estella34/bitirme_fc/docs/donanim/DONANIM_ENVANTERI.md

# Donanım envanteri (Aşama A)

Eldeki her parçanın model kodunu, elektrik değerlerini ve durumunu burada tutuyoruz. Etiket ve bağlantı fotoğraflarını `docs/donanim/foto/` altına koyun ve tabloda dosya adıyla anın. Bilinmeyen alanı tahminle doldurmayın, `?` bırakın.

**Durum değerleri:** `elde` · `sipariş` · `planlanan` · `arızalı`

## Hesaplama ve depolama

| Parça | Model / parça kodu | Elektrik değerleri | Durum | Fotoğraf | Not |
|---|---|---|---|---|---|
| Jetson Orin Nano Developer Kit | ? | 19 V DC | elde | | Bellek (8 GB?) `free -h` ile doğrulanacak |
| Jetson güç adaptörü | ? | ? V / ? A | ? | | |
| microSD kart | ? | — | ? | | Kapasite, hız sınıfı |
| NVMe SSD | ? | — | ? | | Kapasite, M.2 2280 PCIe mi? |

## Kameralar ve aydınlatma

| Parça | Model / parça kodu | Arayüz | Durum | Fotoğraf | Not |
|---|---|---|---|---|---|
| Kamera 1 | ? | CSI / USB? | planlanan | | Sensör, lens, odak türü |
| Kamera 2 | ? | | planlanan | | |
| Kamera 3 | ? | | planlanan | | |
| Kamera 4 | ? | | planlanan | | |
| Çoklu kamera kartı | ? | | ? | | Gerekirse |
| Aydınlatma (LED) | ? | ? V | planlanan | | |

## Araç (yatay hareket)

| Parça | Model / parça kodu | Elektrik değerleri | Durum | Fotoğraf | Not |
|---|---|---|---|---|---|
| Arduino | ? | | elde | | Uno / Mega / Nano? |
| Motor sürücü kartı | ? | ? V / ? A | elde | | |
| Araç motorları | ? | ? V | elde | | Adet, redüktör, enkoder var mı? |
| Batarya | ? | ? V / ? Ah | ? | | |

## Dikey eksen (sıfırdan yapılacak)

| Parça | Model / parça kodu | Elektrik değerleri | Durum | Fotoğraf | Not |
|---|---|---|---|---|---|
| Dikey eksen motoru | — | | planlanan | | Yük ve strok ölçülünce seçilecek |
| Motor sürücüsü | — | | planlanan | | |
| Kılavuz profil / ray | — | — | planlanan | | |
| Vida + somun + yataklar | — | — | planlanan | | |
| Limit anahtarları (2) | — | | planlanan | | |
| Kablo zinciri | — | — | planlanan | | |
