estella34/bitirme_fc/docs/referans/dexory-referans-2026-08-31.jpg

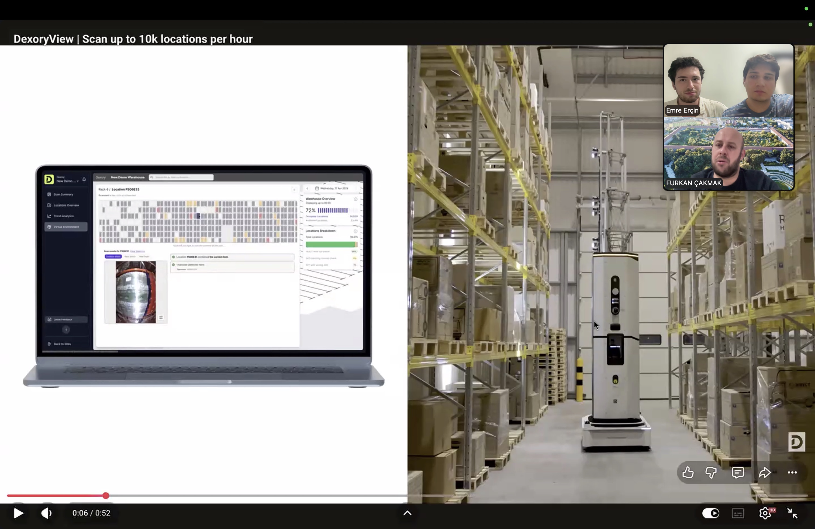
docs/referans/dexory-referans-2026-08-31.jpg
