estella34/bitirme_fc/mekanik/direk_3m/onizleme/base.png

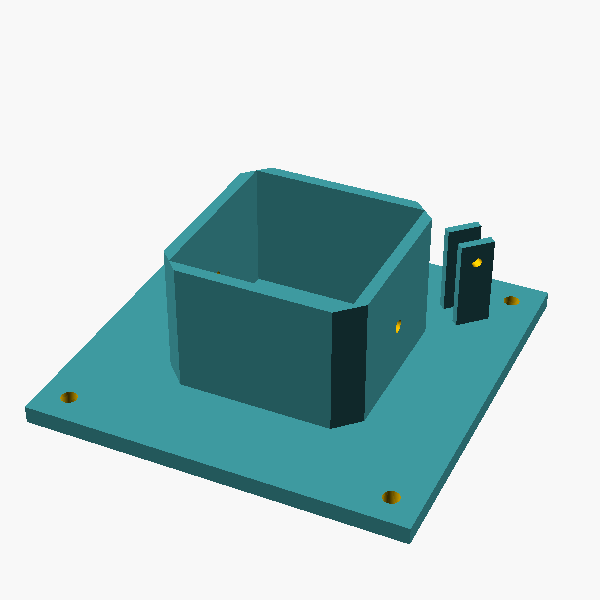
mekanik/direk_3m/onizleme/base.png
