estella34/bitirme_fc/mekanik/direk_3m/onizleme/cap3.png

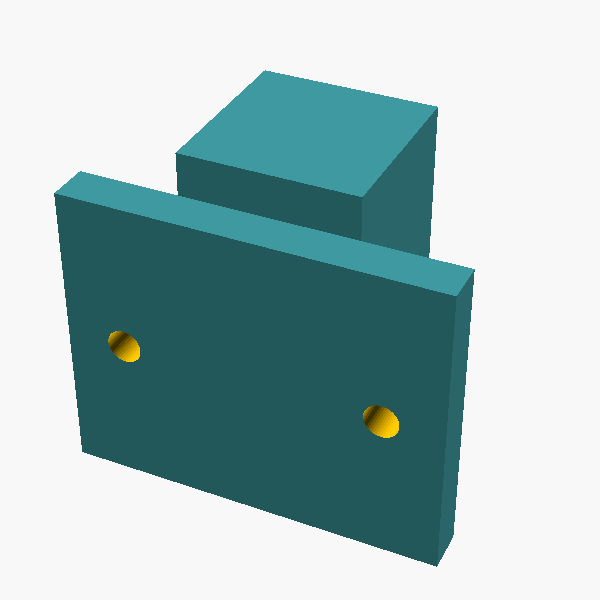
mekanik/direk_3m/onizleme/cap3.png
