estella34/bitirme_fc/mekanik/direk_3m/onizleme/collar0.png

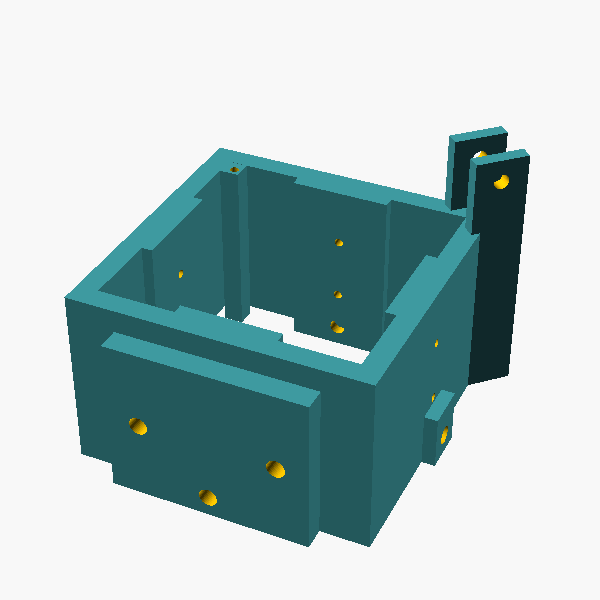
mekanik/direk_3m/onizleme/collar0.png
