estella34/bitirme_fc/mekanik/direk_3m/onizleme/collar1.png

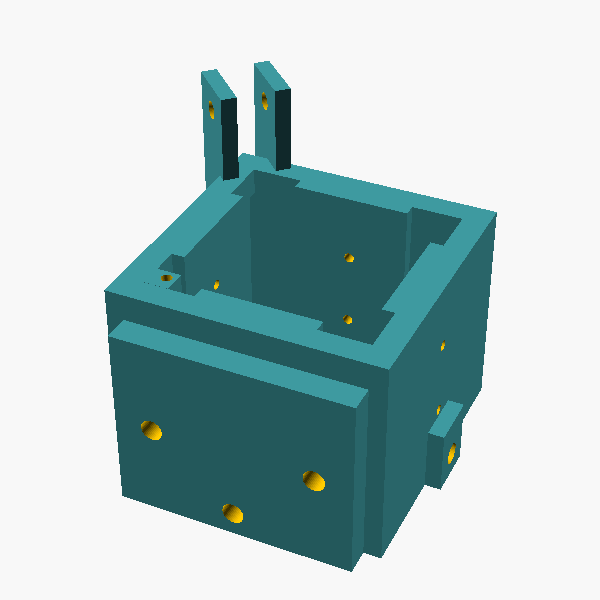
mekanik/direk_3m/onizleme/collar1.png
