estella34/bitirme_fc/mekanik/direk_3m/onizleme/collar2.png

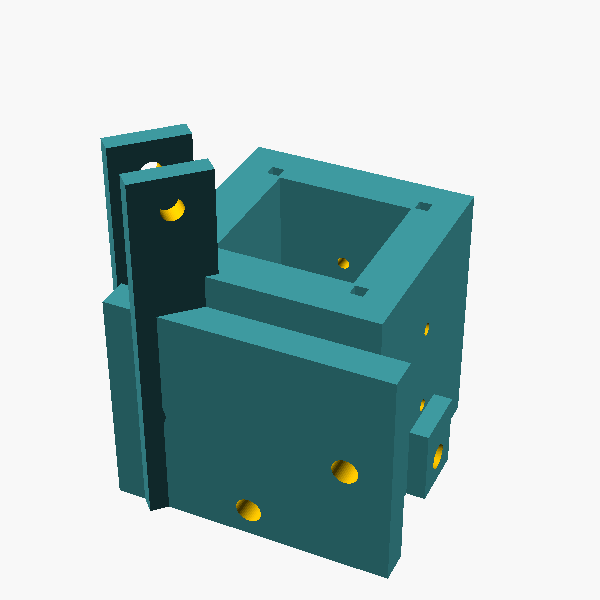
mekanik/direk_3m/onizleme/collar2.png
