estella34/bitirme_fc/mekanik/direk_3m/onizleme/drum.png

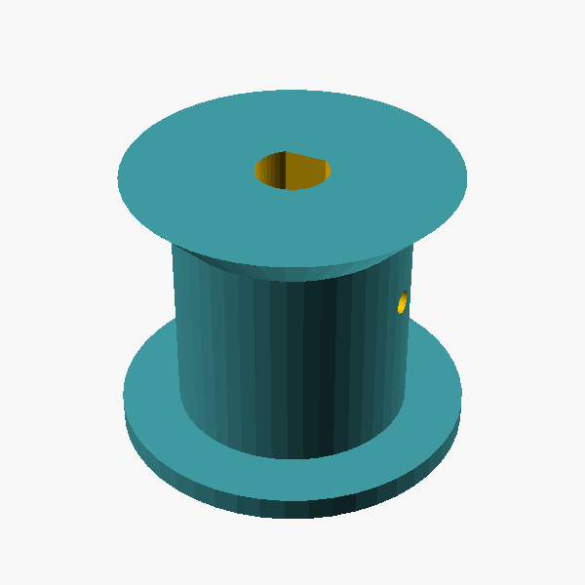
mekanik/direk_3m/onizleme/drum.png
