estella34/bitirme_fc/mekanik/direk_3m/onizleme/pad_2.5.png

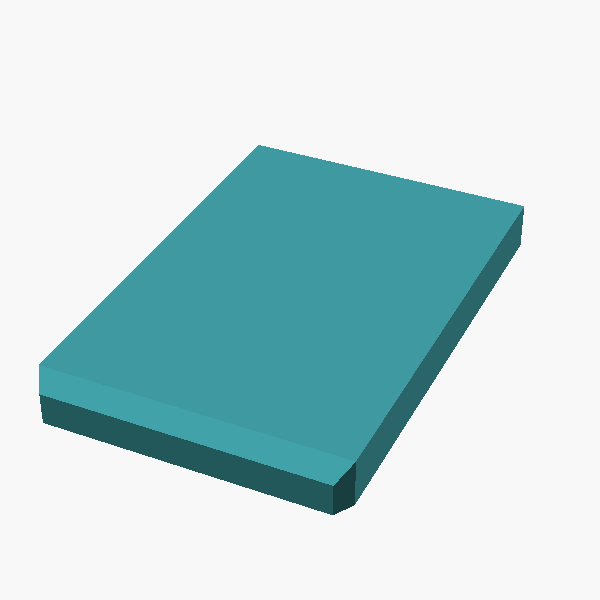
mekanik/direk_3m/onizleme/pad_2.5.png
