estella34/bitirme_fc/mekanik/direk_3m/onizleme/parca_katalogu.png

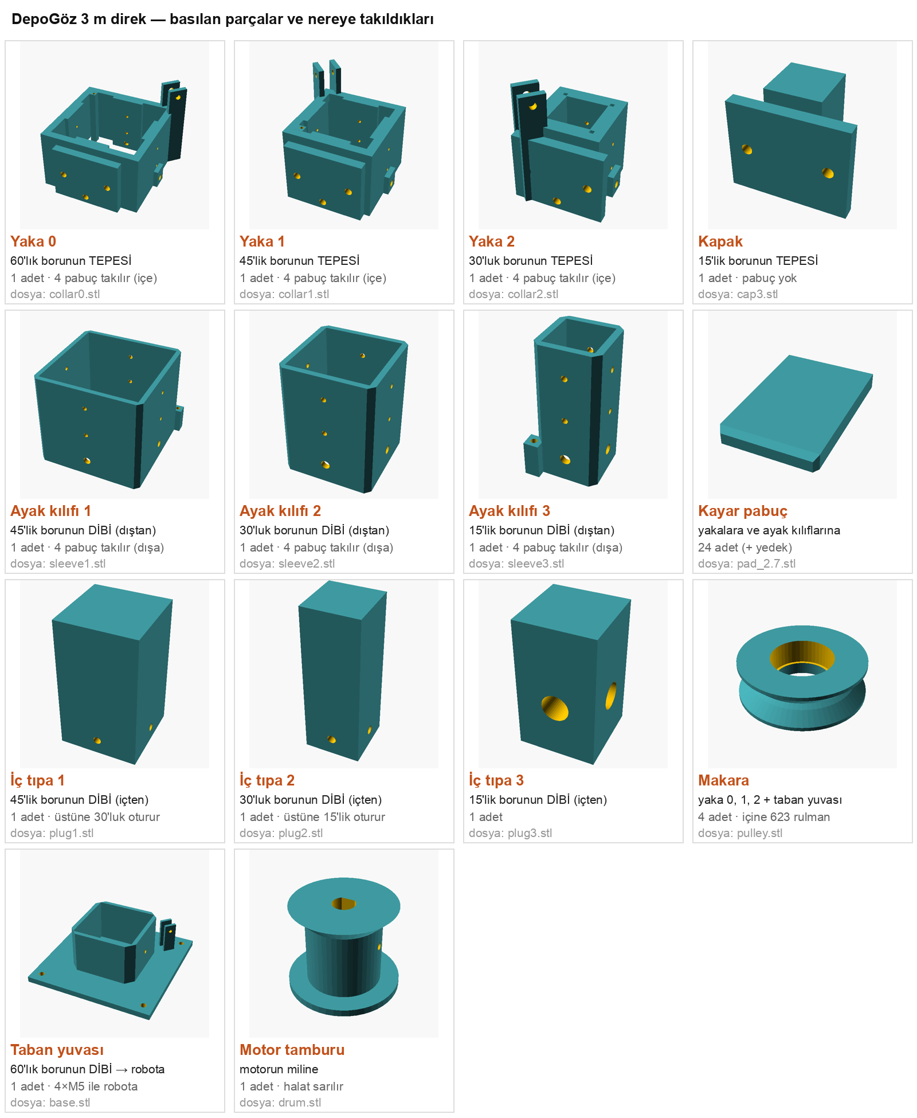
mekanik/direk_3m/onizleme/parca_katalogu.png
