estella34/bitirme_fc/mekanik/direk_3m/onizleme/plug1.png

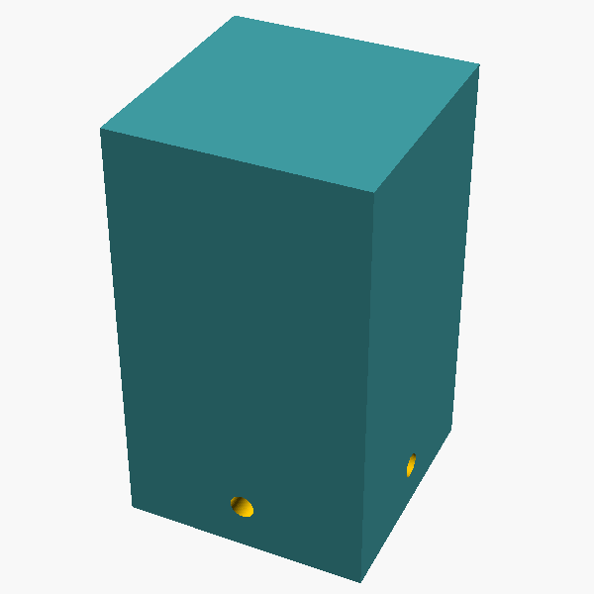
mekanik/direk_3m/onizleme/plug1.png
