estella34/bitirme_fc/mekanik/direk_3m/onizleme/pulley.png

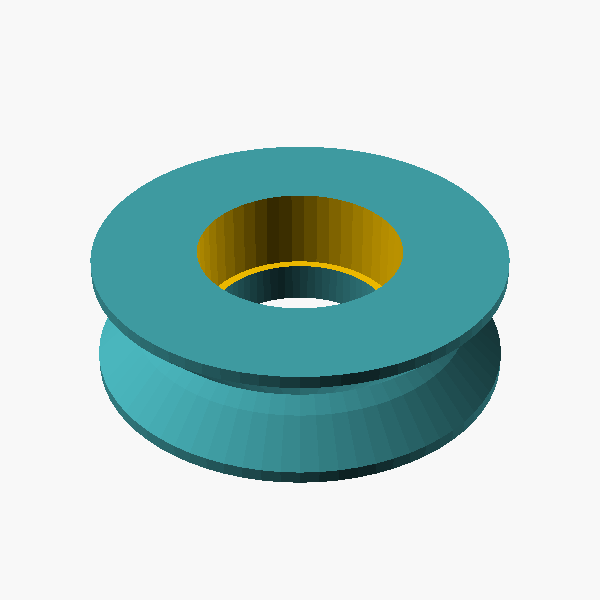
mekanik/direk_3m/onizleme/pulley.png
