estella34/bitirme_fc/mekanik/direk_3m/onizleme/sleeve2.png

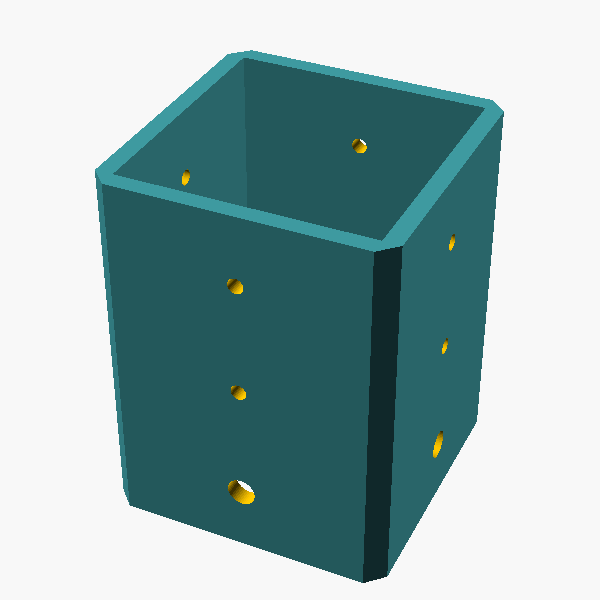
mekanik/direk_3m/onizleme/sleeve2.png
