estella34/bitirme_fc/mekanik/direk_3m/onizleme/sleeve3.png

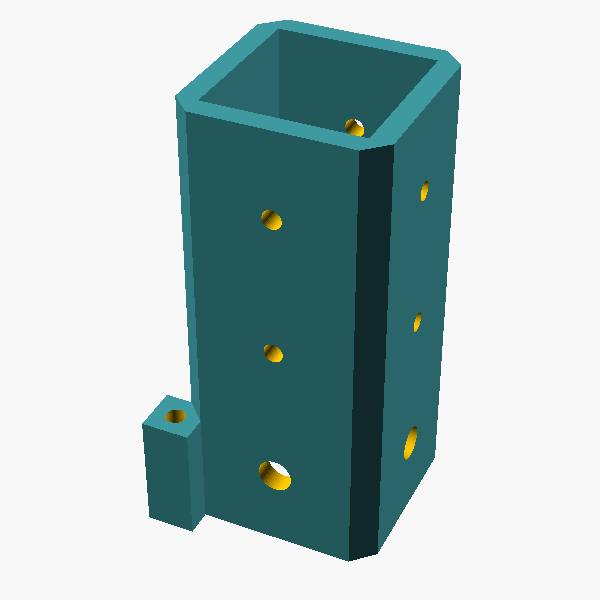
mekanik/direk_3m/onizleme/sleeve3.png
