estella34/bitirme_fc/mekanik/direk_3m/onizleme/yakin_plan.png

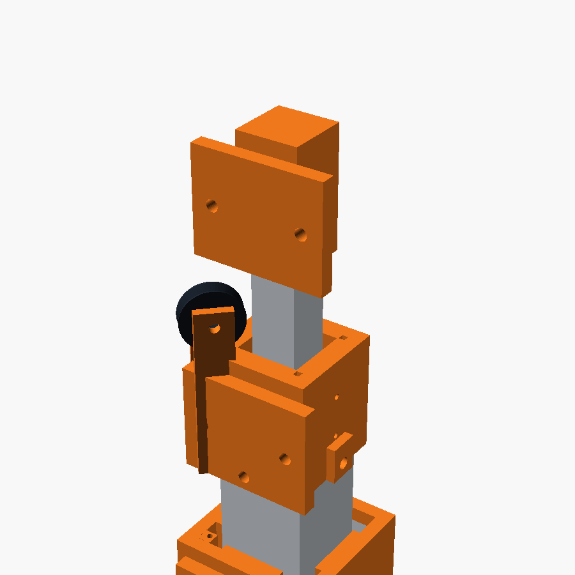
mekanik/direk_3m/onizleme/yakin_plan.png
