estella34/bitirme_fc/mekanik/direk_3m/tablalar/tabla1_pabuclar.png

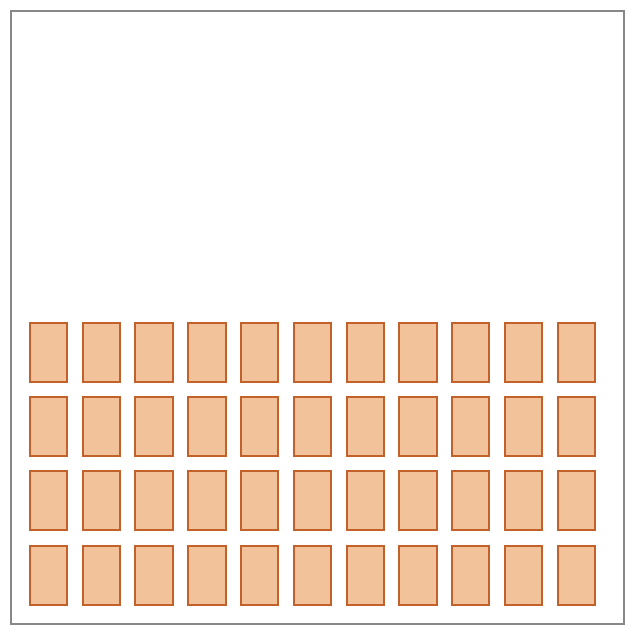
mekanik/direk_3m/tablalar/tabla1_pabuclar.png
