estella34/bitirme_fc/mekanik/direk_3m/tablalar/tabla2_yakalar_makaralar.png

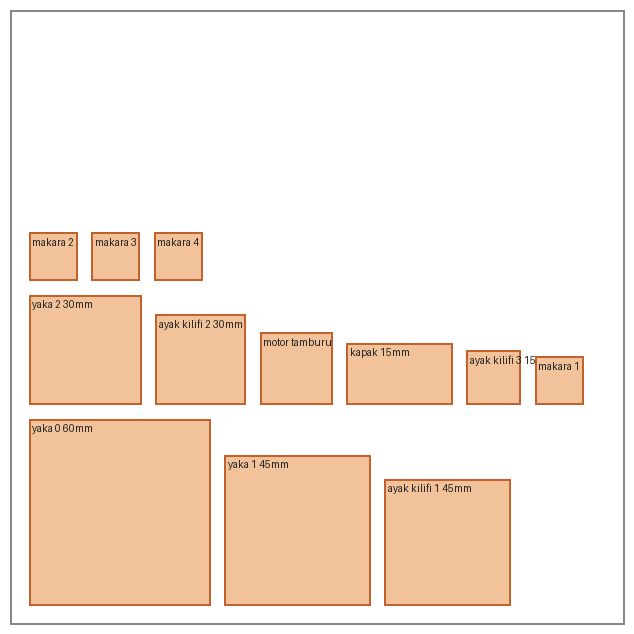
mekanik/direk_3m/tablalar/tabla2_yakalar_makaralar.png
