estella34/bitirme_fc/mekanik/direk_3m/tablalar/tabla3_taban_tipalar.png

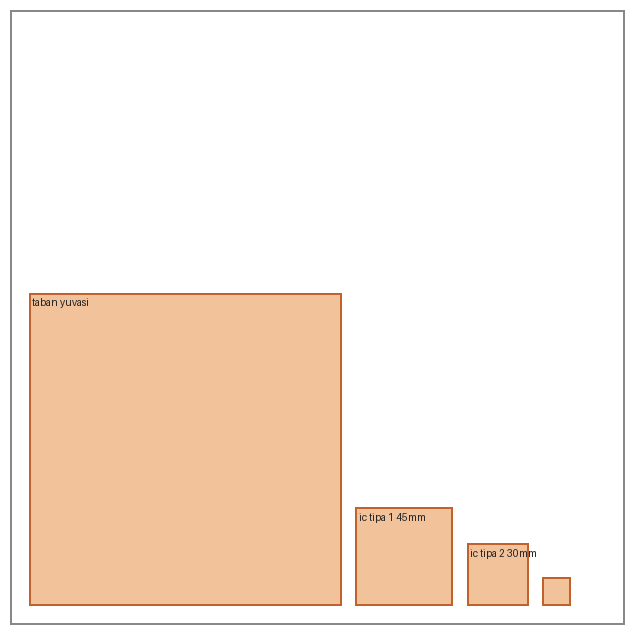
mekanik/direk_3m/tablalar/tabla3_taban_tipalar.png
