estella34/bitirme_fc/mekanik/mini_direk/onizleme/cap3.png

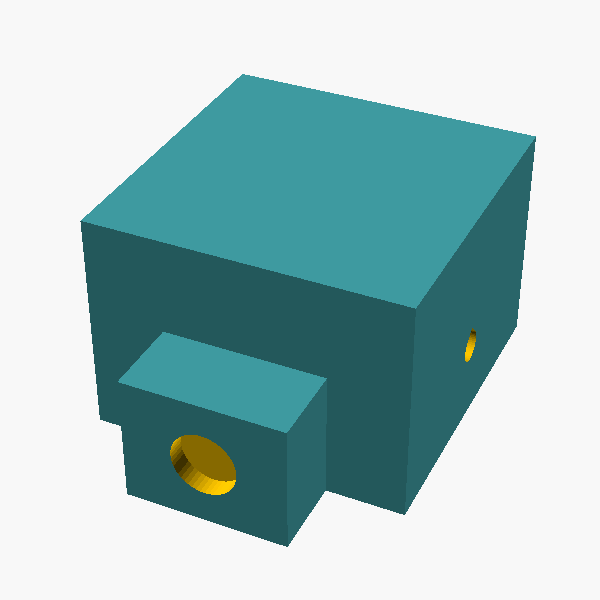
mekanik/mini_direk/onizleme/cap3.png
