estella34/bitirme_fc/mekanik/mini_direk/onizleme/collar0.png

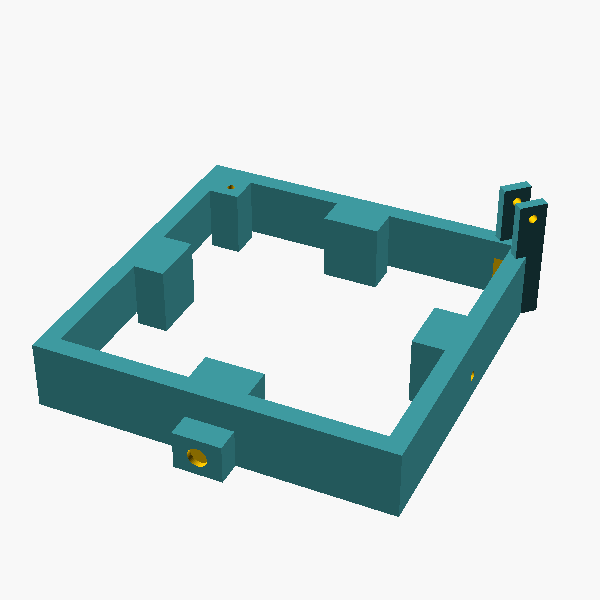
mekanik/mini_direk/onizleme/collar0.png
