estella34/bitirme_fc/mekanik/mini_direk/onizleme/collar1.png

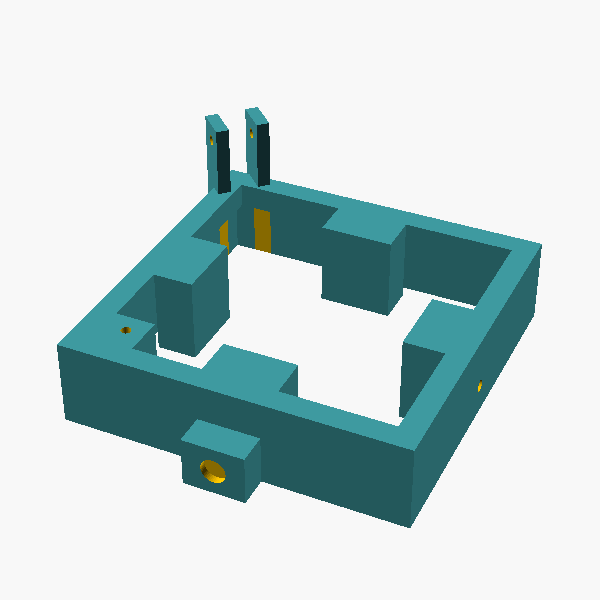
mekanik/mini_direk/onizleme/collar1.png
