estella34/bitirme_fc/mekanik/mini_direk/onizleme/collar2.png

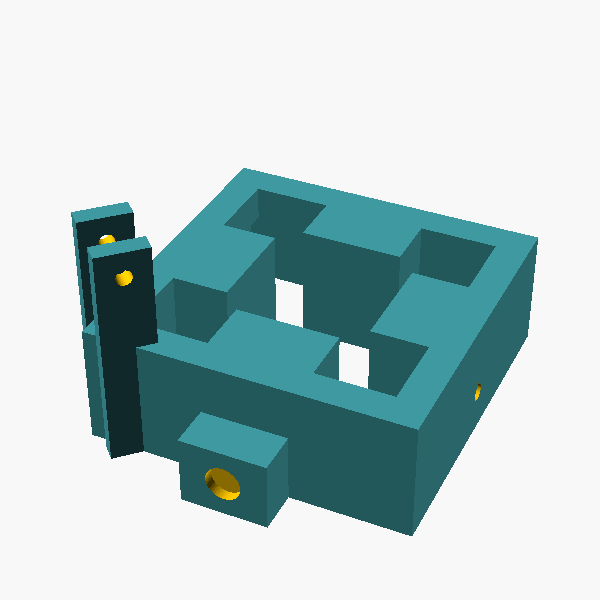
mekanik/mini_direk/onizleme/collar2.png
