estella34/bitirme_fc/mekanik/mini_direk/onizleme/drum.png

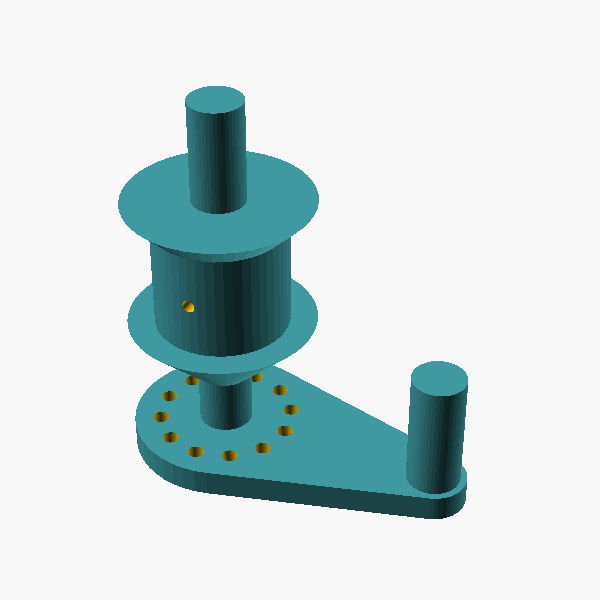
mekanik/mini_direk/onizleme/drum.png
