estella34/bitirme_fc/mekanik/mini_direk/onizleme/pulley.png

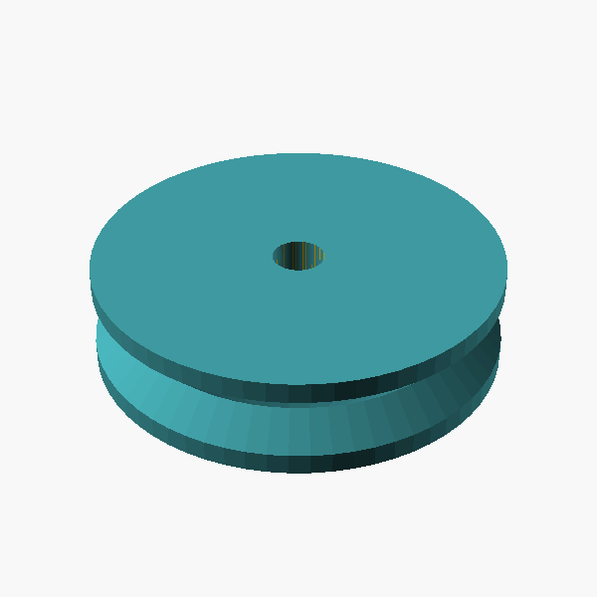
mekanik/mini_direk/onizleme/pulley.png
