estella34/bitirme_fc/mekanik/mini_direk/onizleme/stand.png

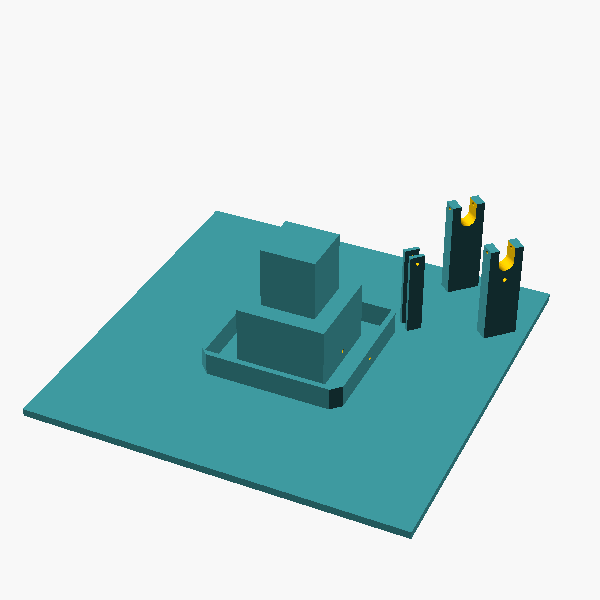
mekanik/mini_direk/onizleme/stand.png
