estella34/bitirme_fc/mekanik/direk_3m/stl/collar1.stl

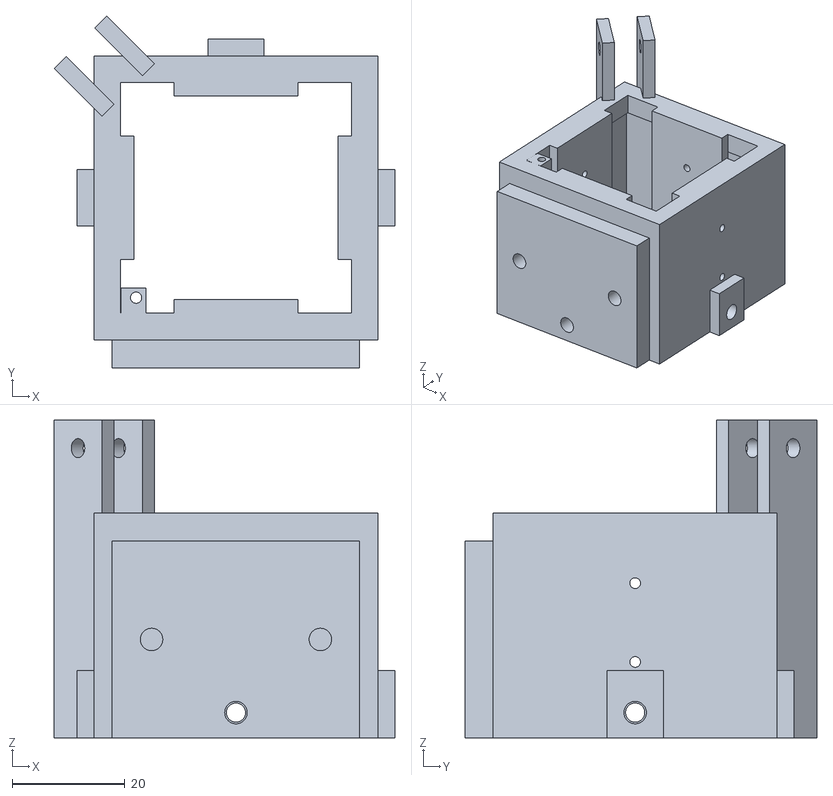
[picture p31: CAD file, 2026-10-04]
mekanik/direk_3m/stl/collar1.stl
60.6 x 62.6 x 56.5
