estella34/bitirme_fc/mekanik/direk_3m/tablalar/tabla1_pabuclar.3mf

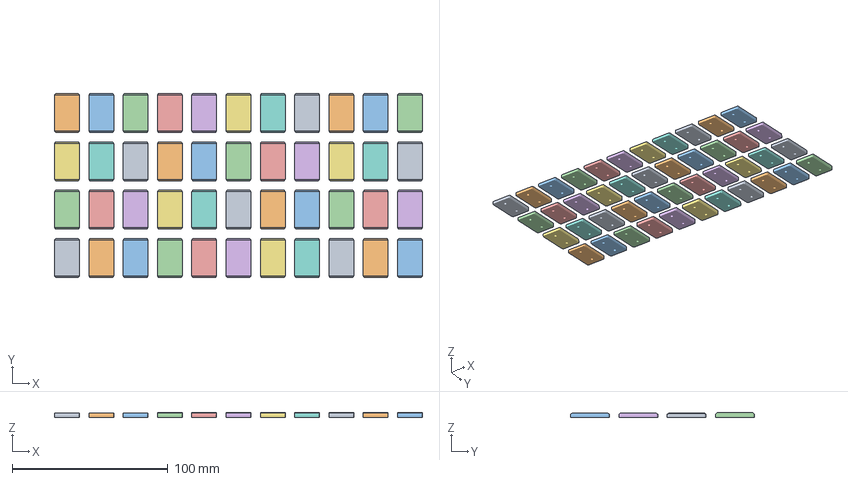
[picture p32: CAD file, 2026-10-04]
mekanik/direk_3m/tablalar/tabla1_pabuclar.3mf
236.0 x 118.0 x 2.90 mm
pabuc_2.7mm_1
pabuc_2.7mm_2
pabuc_2.7mm_3
pabuc_2.7mm_4
pabuc_2.7mm_5
pabuc_2.7mm_6
pabuc_2.7mm_7
pabuc_2.7mm_8
pabuc_2.7mm_9
pabuc_2.7mm_10
pabuc_2.7mm_11
pabuc_2.7mm_12
pabuc_2.7mm_13
pabuc_2.7mm_14
pabuc_2.7mm_15
pabuc_2.7mm_16
pabuc_2.7mm_17
pabuc_2.7mm_18
pabuc_2.7mm_19
pabuc_2.7mm_20
pabuc_2.7mm_21
pabuc_2.7mm_22
pabuc_2.7mm_23
pabuc_2.7mm_24
pabuc_2.7mm_25
pabuc_2.7mm_26
pabuc_2.7mm_27
pabuc_2.7mm_28
pabuc_2.5mm_ince_1
pabuc_2.5mm_ince_2
pabuc_2.5mm_ince_3
pabuc_2.5mm_ince_4
pabuc_2.5mm_ince_5
pabuc_2.5mm_ince_6
pabuc_2.5mm_ince_7
pabuc_2.5mm_ince_8
pabuc_2.9mm_kalin_1
pabuc_2.9mm_kalin_2
pabuc_2.9mm_kalin_3
pabuc_2.9mm_kalin_4
pabuc_2.9mm_kalin_5
pabuc_2.9mm_kalin_6
pabuc_2.9mm_kalin_7
pabuc_2.9mm_kalin_8
