estella34/bitirme_fc/mekanik/mini_direk/stl/tube2.stl

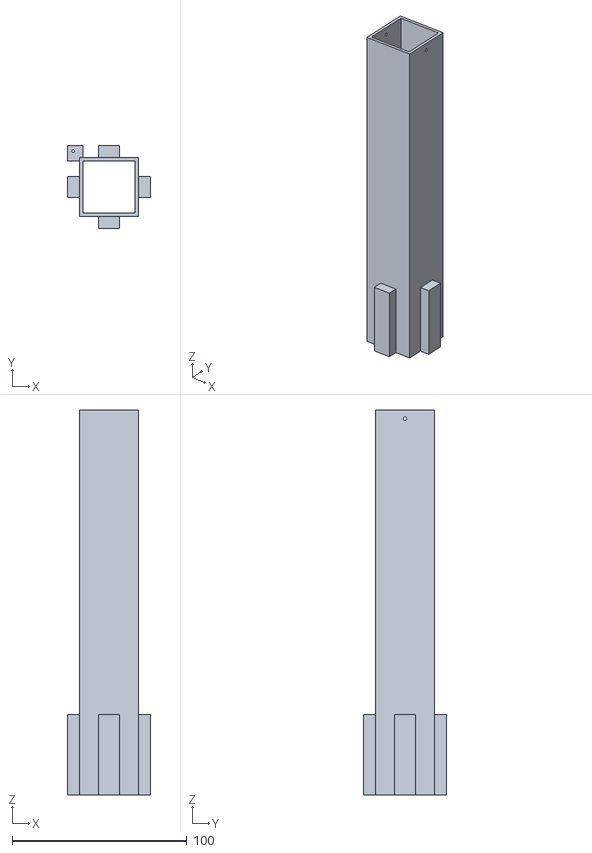
[picture p33: CAD file, 2026-10-04]
mekanik/mini_direk/stl/tube2.stl
47.2 x 47.2 x 220.0
