estella34/bitirme_fc/mekanik/direk_3m/stl/collar2.stl

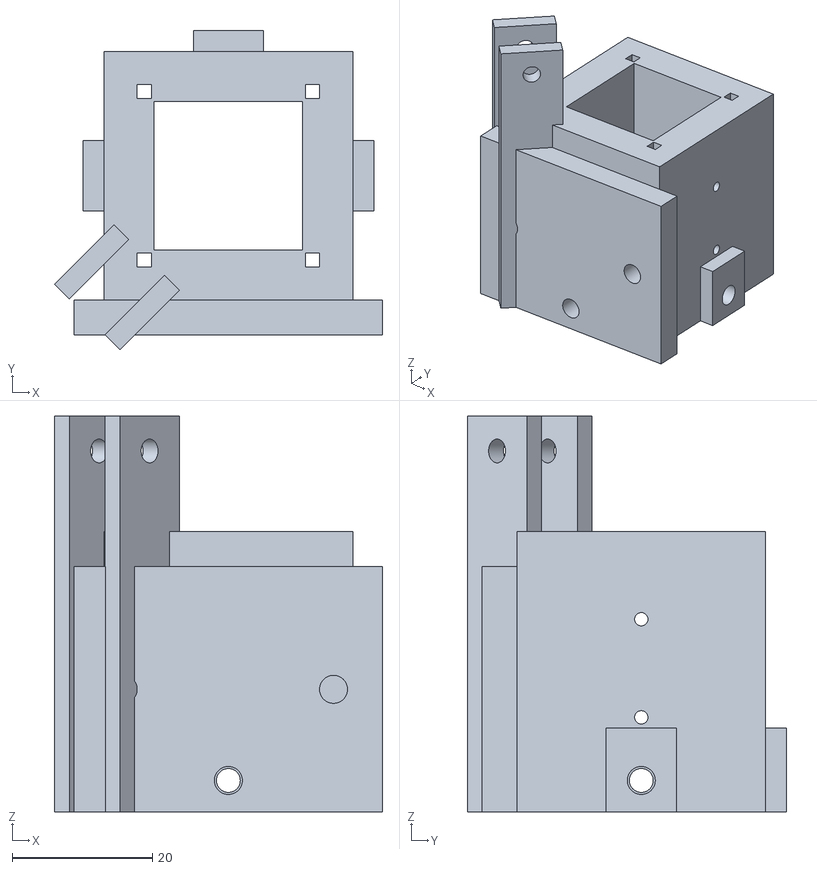
[picture p34: CAD file, 2026-10-04]
mekanik/direk_3m/stl/collar2.stl
46.8 x 45.6 x 56.5
