estella34/bitirme_fc/mekanik/direk_3m/tablalar/tabla2_yakalar_makaralar.3mf

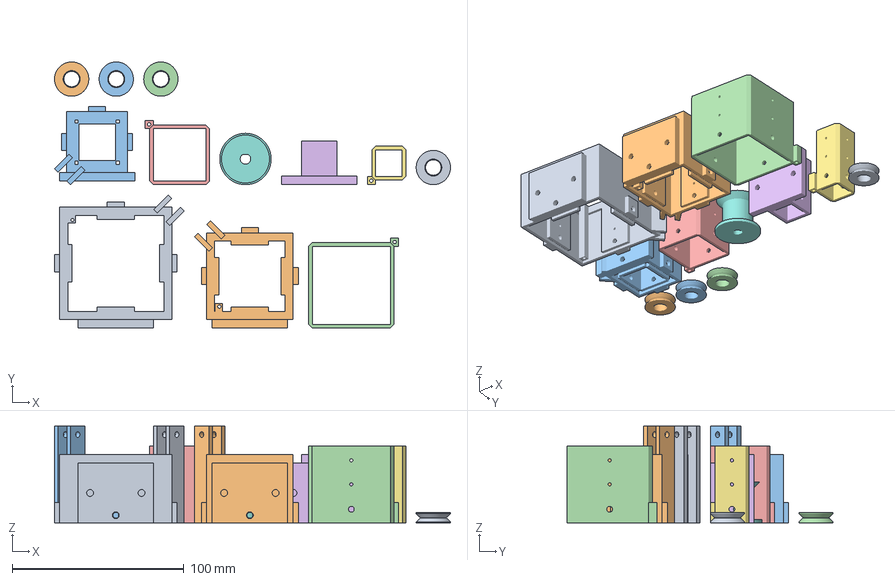
[picture p35: CAD file, 2026-10-04]
mekanik/direk_3m/tablalar/tabla2_yakalar_makaralar.3mf
230.8 x 155.1 x 56.5 mm
yaka_0_60mm
yaka_1_45mm
yaka_2_30mm
ayak_kilifi_1_45mm
ayak_kilifi_2_30mm
kapak_15mm
ayak_kilifi_3_15mm
motor_tamburu
makara_1
makara_2
makara_3
makara_4
