estella34/bitirme_fc/mekanik/mini_direk/stl/tube1.stl

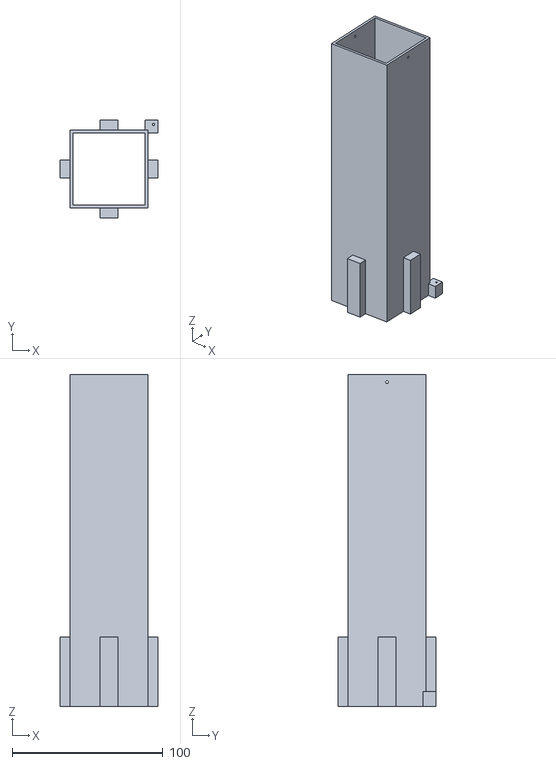
[picture p36: CAD file, 2026-10-04]
mekanik/mini_direk/stl/tube1.stl
65.2 x 65.2 x 220.0
