estella34/bitirme_fc/mekanik/direk_3m/stl/pulley.stl

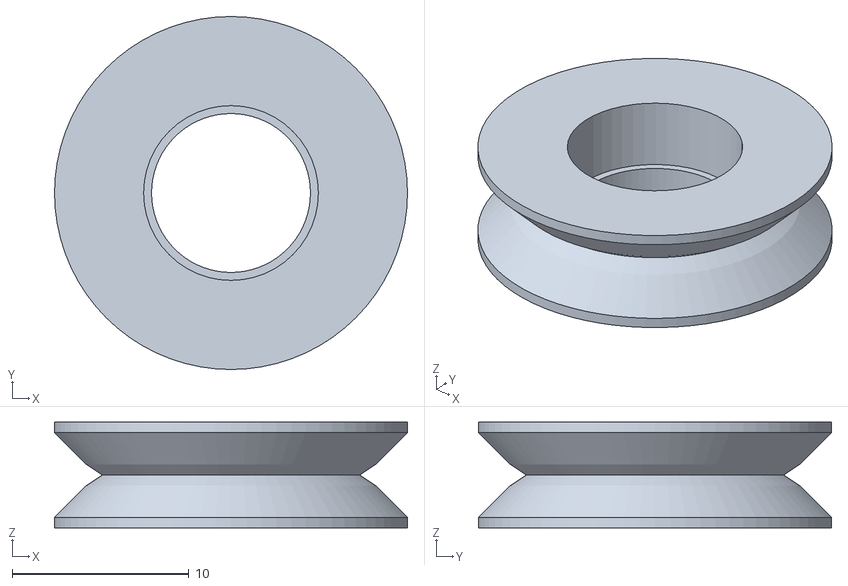
[picture p37: CAD file, 2026-10-04]
mekanik/direk_3m/stl/pulley.stl
20.0 x 20.0 x 6.00
