estella34/bitirme_fc/mekanik/direk_3m/tablalar/tabla3_taban_tipalar.3mf

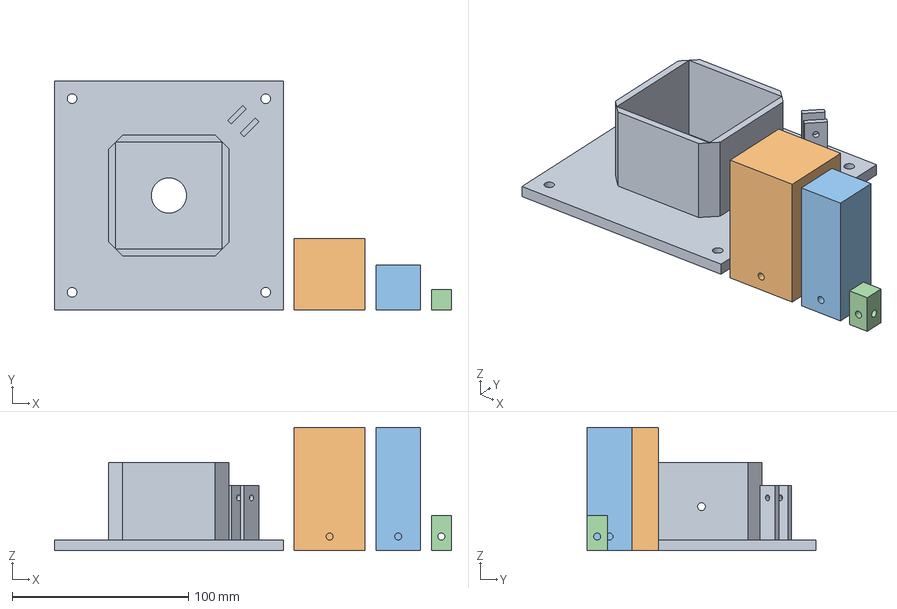
[picture p38: CAD file, 2026-10-04]
mekanik/direk_3m/tablalar/tabla3_taban_tipalar.3mf
225.5 x 130.0 x 70.0 mm
taban_yuvasi
ic_tipa_1_45mm
ic_tipa_2_30mm
ic_tipa_3_15mm
