estella34/bitirme_fc/mekanik/mini_direk/stl/pulley.stl

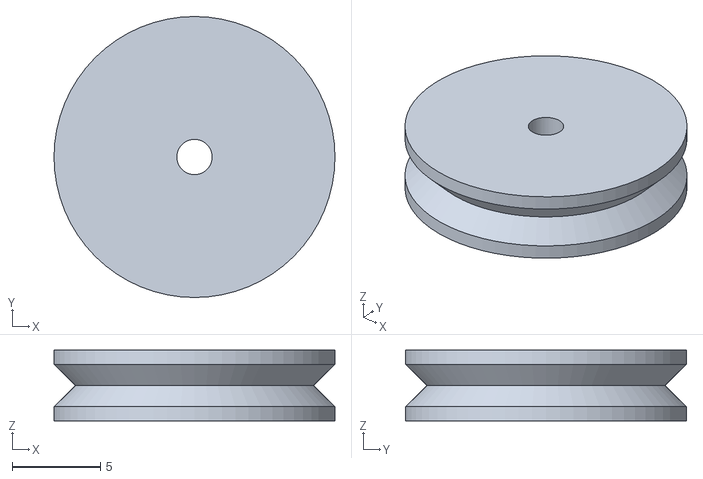
[picture p39: CAD file, 2026-10-04]
mekanik/mini_direk/stl/pulley.stl
15.9 x 15.9 x 4.00
