estella34/bitirme_fc/mekanik/direk_3m/stl/collar0.stl

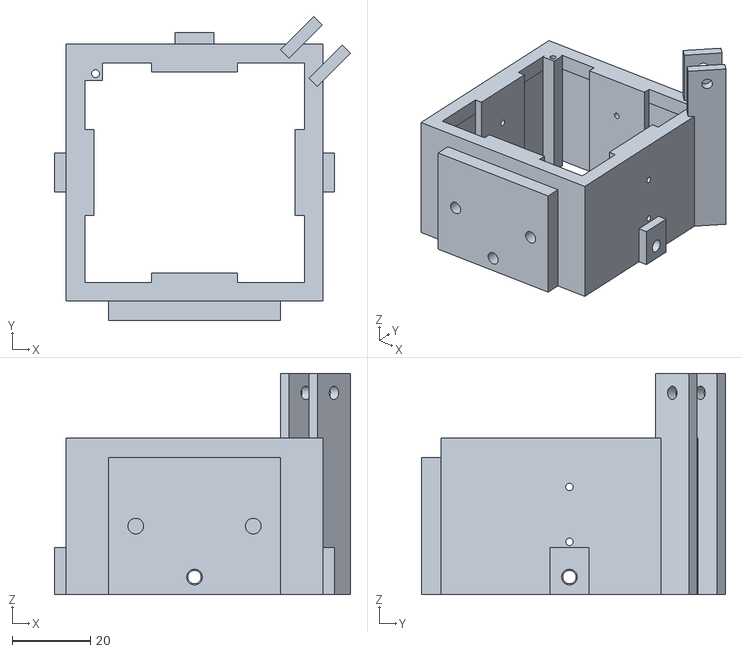
[picture p40: CAD file, 2026-10-04]
mekanik/direk_3m/stl/collar0.stl
75.6 x 77.6 x 56.5
