estella34/bitirme_fc/mekanik/mini_direk/stl/collar1.stl

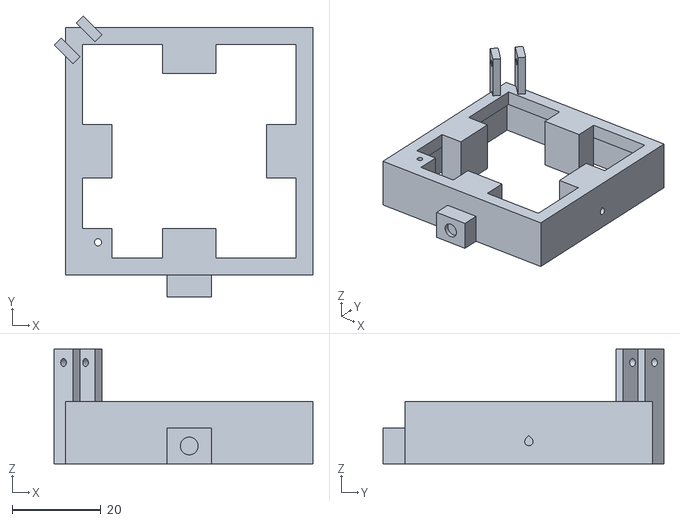
[picture p41: CAD file, 2026-10-04]
mekanik/mini_direk/stl/collar1.stl
58.2 x 63.2 x 25.8
