estella34/bitirme_fc/mekanik/direk_3m/stl/base.stl

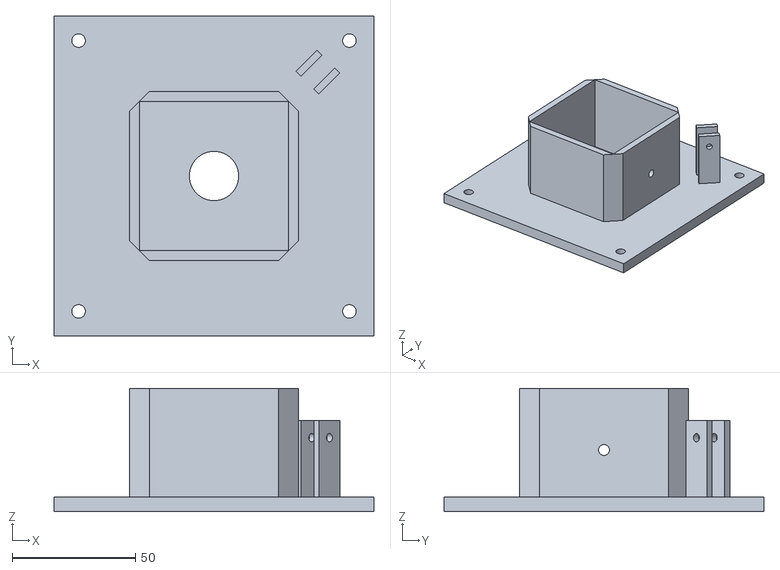
[picture p42: CAD file, 2026-10-04]
mekanik/direk_3m/stl/base.stl
130.0 x 130.0 x 50.0
