estella34/bitirme_fc/mekanik/mini_direk/stl/tube0.stl

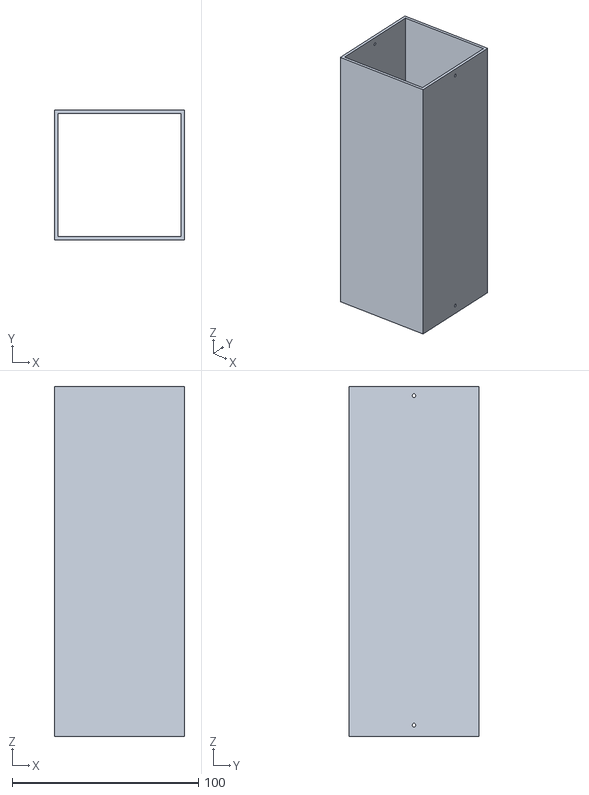
[picture p43: CAD file, 2026-10-04]
mekanik/mini_direk/stl/tube0.stl
70.0 x 70.0 x 188.0
