estella34/bitirme_fc/mekanik/direk_3m/stl/sleeve3.stl

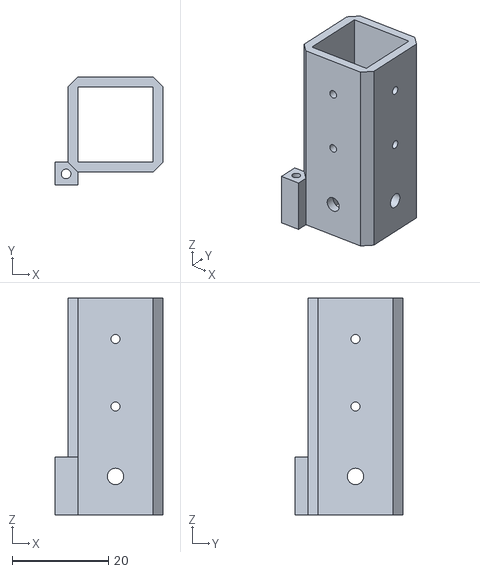
[picture p44: CAD file, 2026-10-04]
mekanik/direk_3m/stl/sleeve3.stl
22.5 x 22.5 x 45.0
