estella34/bitirme_fc/mekanik/mini_direk/stl/drum.stl

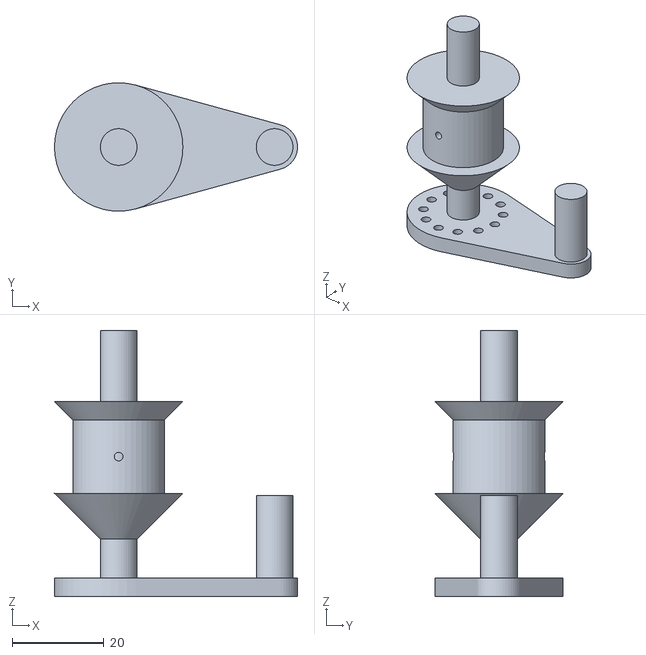
[picture p45: CAD file, 2026-10-04]
mekanik/mini_direk/stl/drum.stl
53.0 x 28.0 x 58.0
