estella34/bitirme_fc/mekanik/direk_3m/stl/cap3.stl

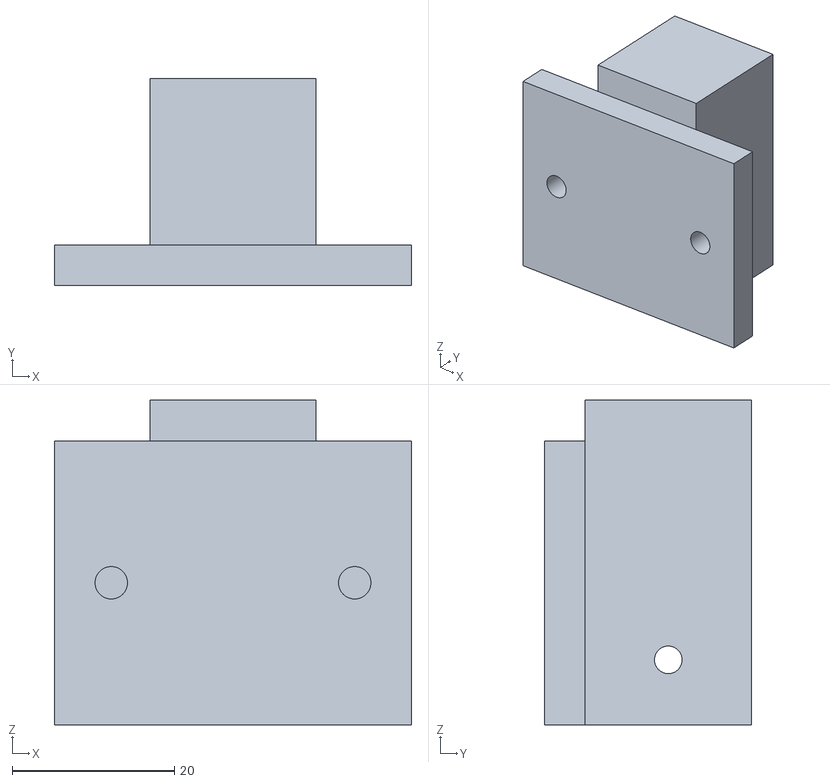
[picture p46: CAD file, 2026-10-04]
mekanik/direk_3m/stl/cap3.stl
44.0 x 25.5 x 40.0
