estella34/bitirme_fc/mekanik/mini_direk/stl/cap3.stl

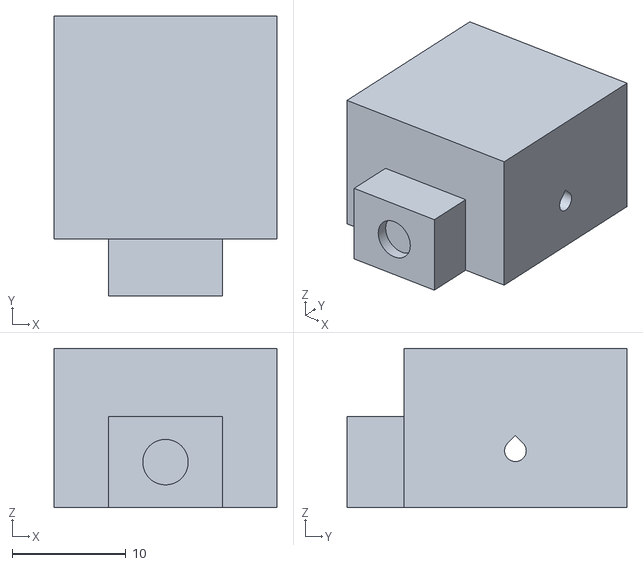
[picture p47: CAD file, 2026-10-04]
mekanik/mini_direk/stl/cap3.stl
19.6 x 24.6 x 14.0
