estella34/bitirme_fc/mekanik/mini_direk/stl/stand.stl

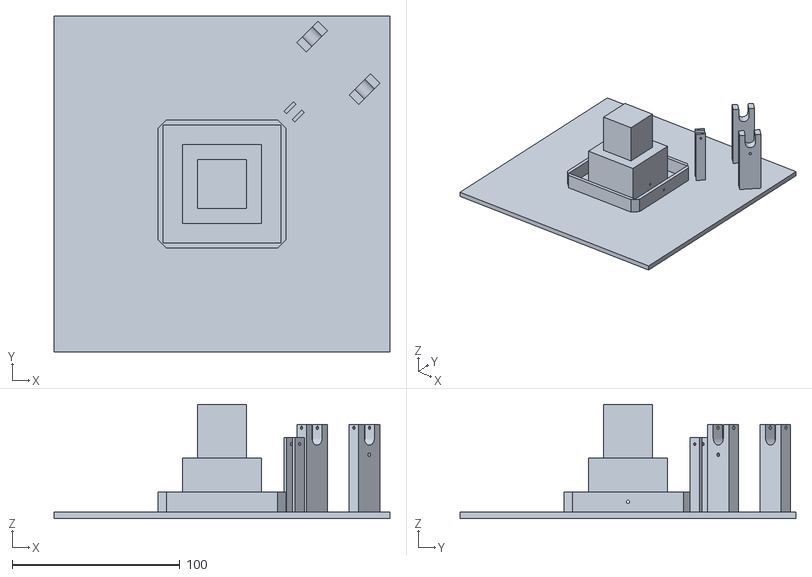
[picture p49: CAD file, 2026-10-04]
mekanik/mini_direk/stl/stand.stl
200.0 x 200.0 x 68.0
