estella34/bitirme_fc/mekanik/direk_3m/stl/plug2.stl

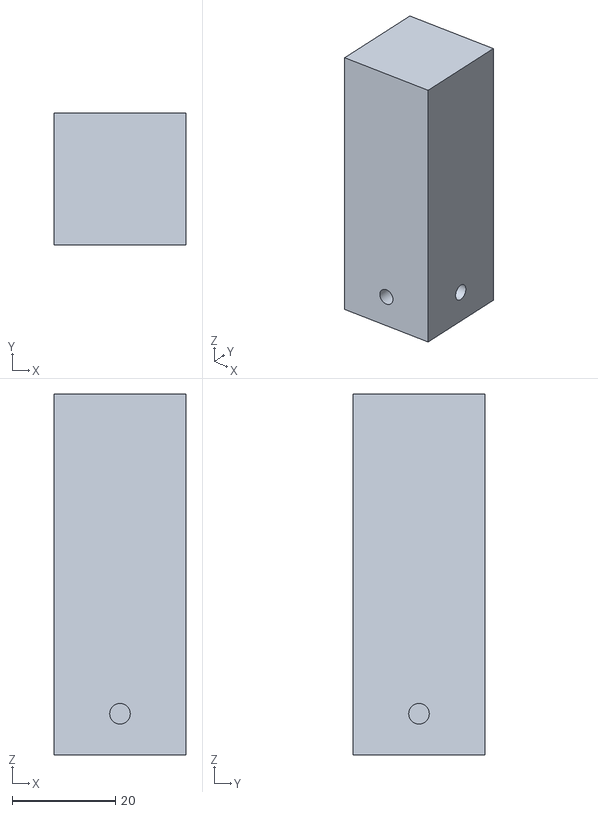
[picture p50: CAD file, 2026-10-04]
mekanik/direk_3m/stl/plug2.stl
25.5 x 25.5 x 70.0
