estella34/bitirme_fc/mekanik/mini_direk/stl/collar2.stl

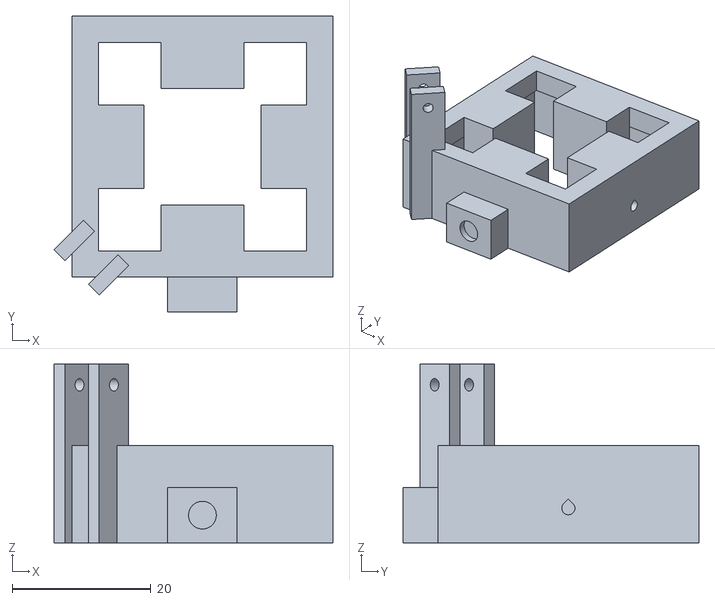
[picture p51: CAD file, 2026-10-04]
mekanik/mini_direk/stl/collar2.stl
40.2 x 42.6 x 25.8
