estella34/bitirme_fc/mekanik/direk_3m/stl/sleeve1.stl

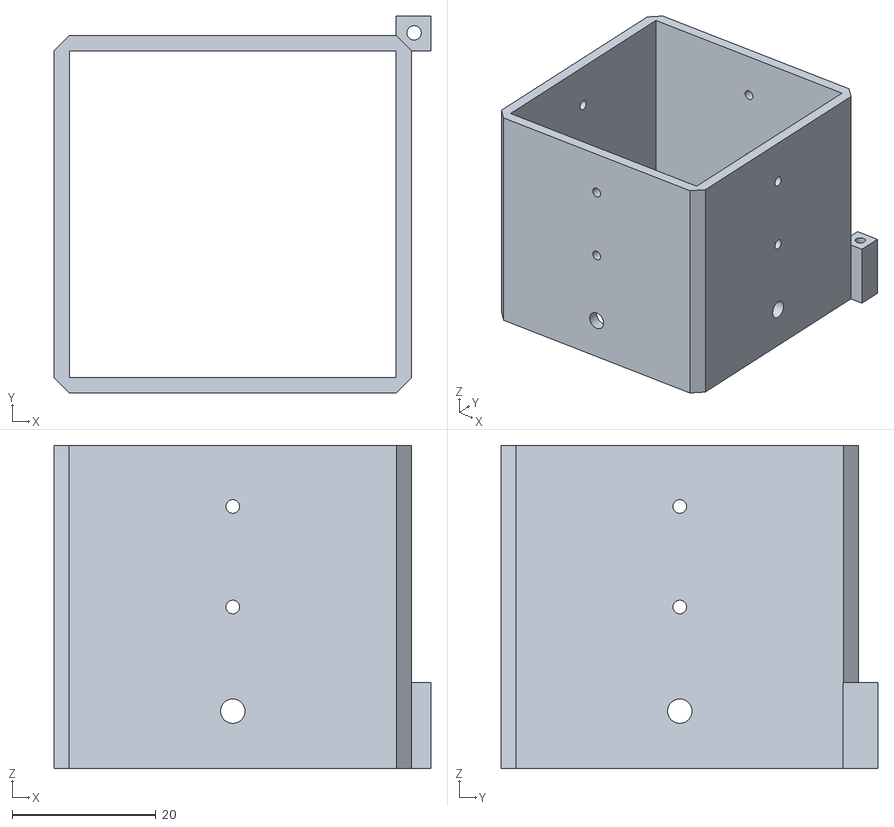
[picture p52: CAD file, 2026-10-04]
mekanik/direk_3m/stl/sleeve1.stl
52.5 x 52.5 x 45.0
