estella34/bitirme_fc/mekanik/mini_direk/stl/collar0.stl

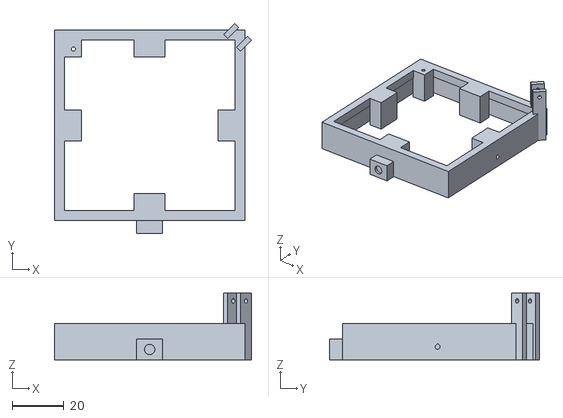
[picture p53: CAD file, 2026-10-04]
mekanik/mini_direk/stl/collar0.stl
76.2 x 81.2 x 25.8
