estella34/bitirme_fc/mekanik/direk_3m/stl/drum.stl

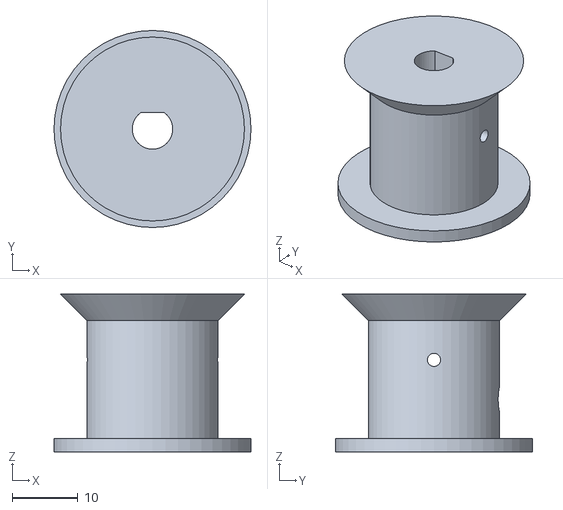
[picture p54: CAD file, 2026-10-04]
mekanik/direk_3m/stl/drum.stl
30.0 x 30.0 x 24.0
