estella34/bitirme_fc/mekanik/mini_direk/stl/tube3.stl

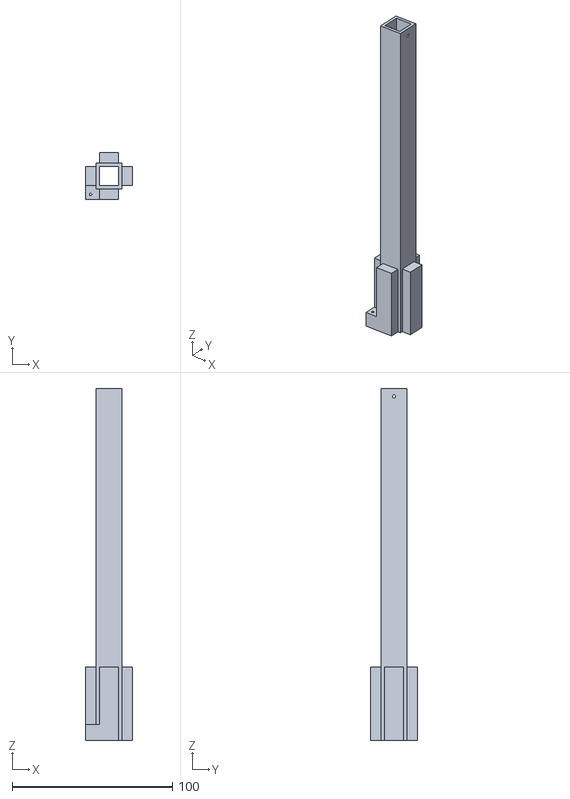
[picture p55: CAD file, 2026-10-04]
mekanik/mini_direk/stl/tube3.stl
29.2 x 29.2 x 220.0
