estella34/bitirme_fc/mekanik/direk_3m/stl/pad_2.7.stl

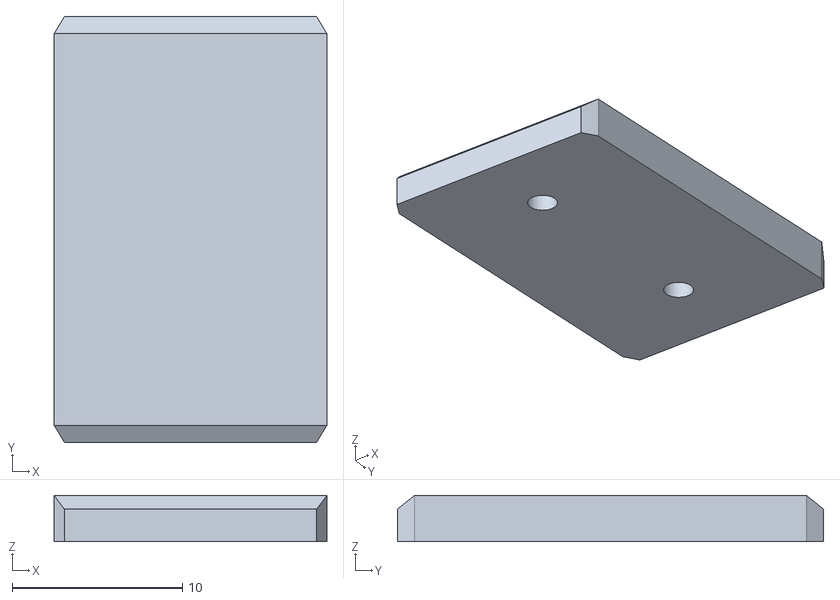
[picture p56: CAD file, 2026-10-04]
mekanik/direk_3m/stl/pad_2.7.stl
16.0 x 25.0 x 2.70
