estella34/bitirme_fc/mekanik/direk_3m/stl/pad_2.9.stl

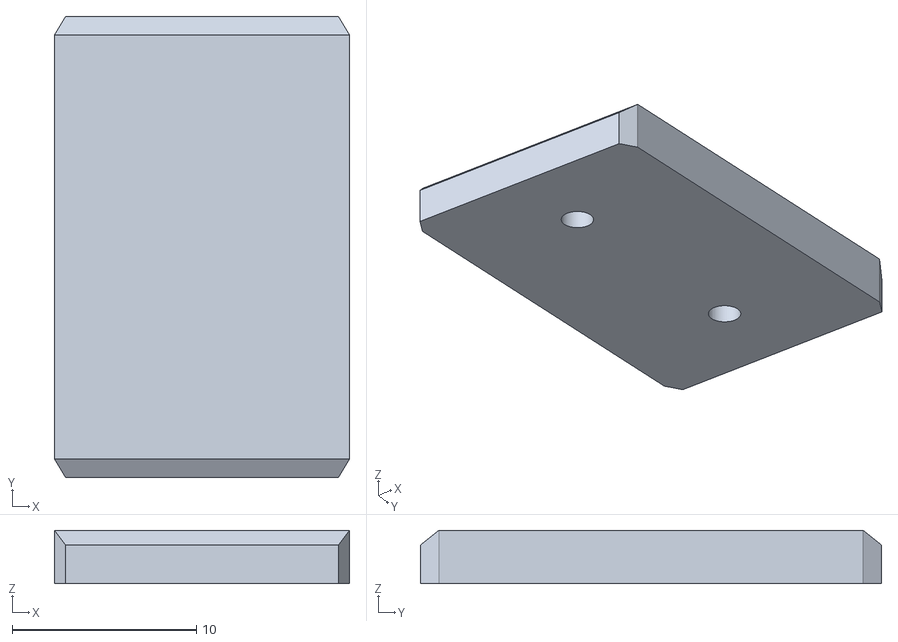
[picture p57: CAD file, 2026-10-04]
mekanik/direk_3m/stl/pad_2.9.stl
16.0 x 25.0 x 2.90
