estella34/bitirme_fc/mekanik/direk_3m/stl/plug1.stl

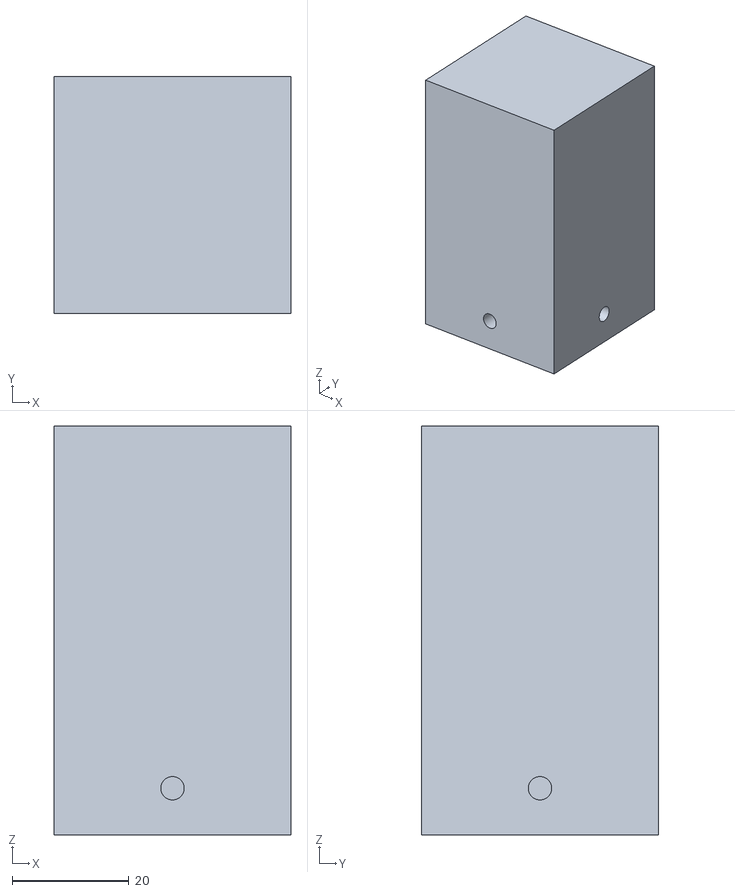
[picture p58: CAD file, 2026-10-04]
mekanik/direk_3m/stl/plug1.stl
40.5 x 40.5 x 70.0
