estella34/bitirme_fc/mekanik/direk_3m/stl/sleeve2.stl

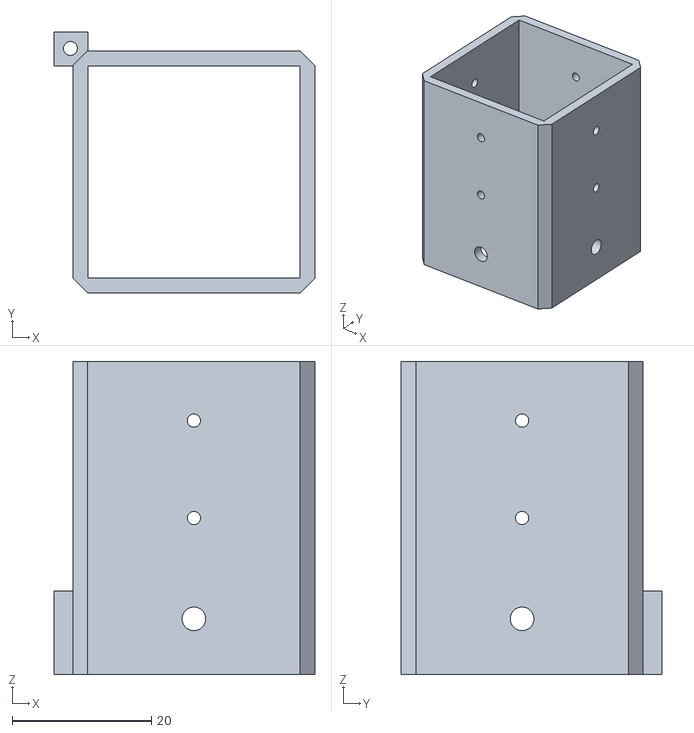
[picture p59: CAD file, 2026-10-04]
mekanik/direk_3m/stl/sleeve2.stl
37.5 x 37.5 x 45.0
