estella34/bitirme_fc/mekanik/direk_3m/stl/plug3.stl

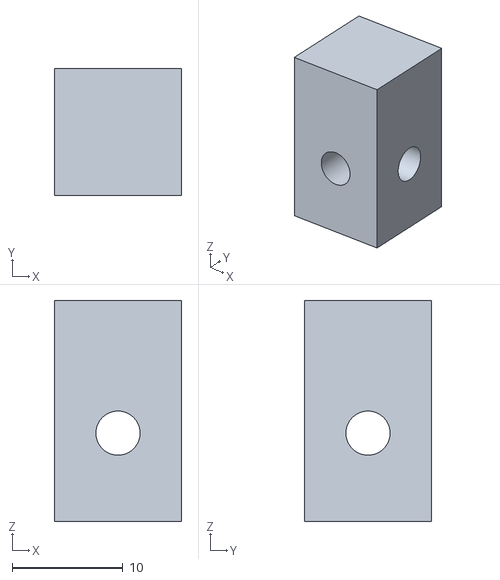
[picture p60: CAD file, 2026-10-04]
mekanik/direk_3m/stl/plug3.stl
11.5 x 11.5 x 20.0
