estella34/bitirme_fc/depogoz_test_sayfasi.pdf

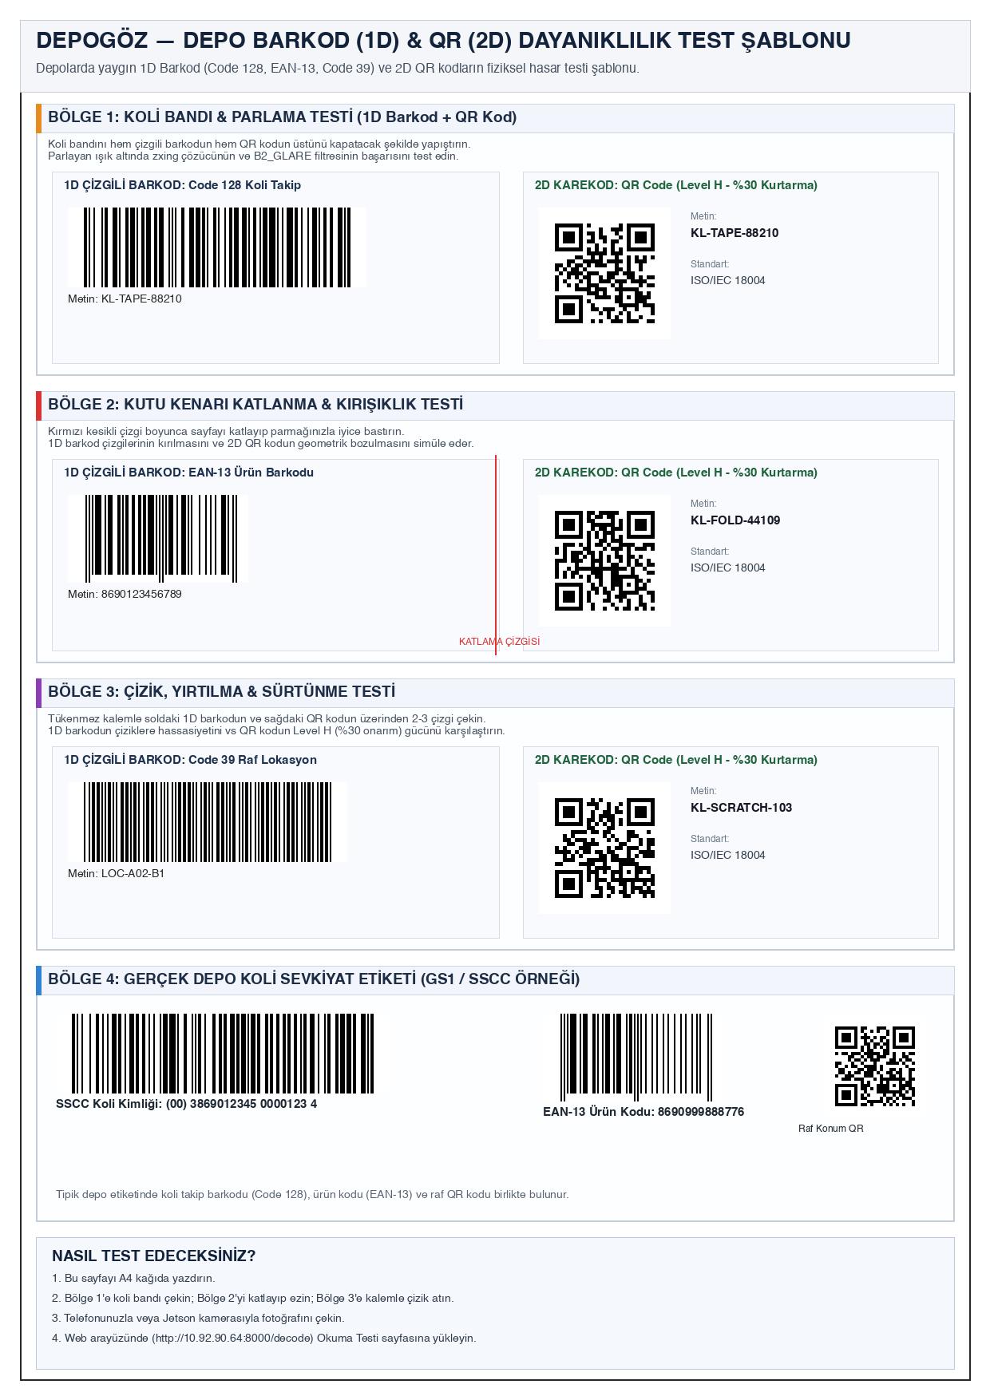
[picture p61: page 1]
