estella34/bitirme_fc/(commit log)

2026-10-03 Proje deposunu başlat: belgeler ve Jetson kurulum altyapısı
    - Mevcut belgeler (yol haritası, mekanizma taslağı, index.html) docs/ altına taşındı
    - Proje brifingi, teknik karar kaydı ve donanım envanteri şablonu eklendi
    - Jetson Orin Nano kurulum rehberi (JetPack 6.2.1 / 7.2.1 yolları, firmware kontrolü)
    - jetson/scripts: kurulum sonrası betiği ve sağlık kontrolü raporu betiği
    - .gitignore, .gitattributes (LF), .editorconfig
2026-10-03 docs: Jetson güç beslemesi ve fiş dönüşümü notu
2026-10-03 docs: K-002 kararı — JetPack 6.2.1
2026-10-03 backend: FastAPI envanter sunucusu, kod okuma, mutabakat ve demo simülasyonu
    - zxing-cpp ile QR + barkod çözme (B0 tam görüntü, B1 ön işleme yedeği, A1 için kırpma desteği)
    - Mutabakat kuralları: doğrulandı / okundu / okunamadı / boş / çelişki, inceleme kuyruğu
    - Tarama ve görüntü alma API'si, CSV dışa aktarma, beklenen stok içe aktarma
    - Robot telemetrisi: LiDAR noktaları → voksel haritası, WebSocket canlı yayın
    - Demo: depo, raflar, 3B LiDAR ve kamera simülasyonu; görüntüler gerçek çözücüden geçer
    - 26 test
2026-10-03 web: 3B dijital ikiz arayüzü, inceleme kuyruğu, taramalar ve okuma testi
    - React + three.js: raflar, koliler (doğrulandı / hayalet kayıp koli / yanlış koli / okunamadı),
    canlı LiDAR haritası, anlık tarama ışını, robot modeli (mast + kamera taşıyıcı) ve izi
    - Yan panel: vardiya özeti, mini raf haritası, son çekim (QR konumlarıyla), olay akışı,
    göz ayrıntısı ve manuel kontrol (onayla / sahada düzeltildi)
    - Panelden seçilen göze kamera odaklanması; perspektif / üstten / robotu izle
    - Yazı tipleri pakete gömülü (internetsiz ağda çalışır)
    - docs/YAZILIM.md: mimari, çalıştırma, robot API'si, Jetson kurulumu; systemd birimi
    - iCloud: venv ve node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
2026-10-03 Proje adı DepoGöz; aydınlık/karanlık tema
    - Arayüz: sağ üstte tema düğmesi; tercih tarayıcıda saklanır, seçilmediyse sistem teması izlenir.
    Tema ilk boyamadan önce ayarlanır (yanıp sönme yok). DOM renkleri CSS değişkenlerinde,
    3B sahne renkleri (zemin, ışık, raflar, koliler, LiDAR) theme.ts paletlerinde
    - Aydınlık tema: beton zeminli gündüz deposu; durum metinleri için koyulaştırılmış renkler
    - Yeni marka işareti: raf gözü (dikme + kiriş) içinde bir göz
    - Arkadaki rafların etiketleri artık gizleniyor (Html occlusion); seçili göz etiketi kirişin önünde
    - Ad: DepoGöz (arayüz, API başlığı, `depogoz` komutu, `depogoz.service`, belgeler, yo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
2026-10-04 mekanik: tamamı PLA basılabilen mini teleskopik direk (OpenSCAD)
    - 4 iç içe kare boru (dahili ayak pabuçları ve halat kulakları), 3 yaka (üst pabuç,
    makara kulağı, halat bağlama), kapak, makara, taban (soket + basamaklı kaide +
    yönlendirme makarası + vinç yatakları), krank/tambur
    - Ölçüler parametrik; build.sh STL ve önizleme üretir
    - Çakışma testi: 0/60/125/132 mm açıklıkta parça çakışması yok; 132 mm'de durdurucu devrede
    - README: baskı ayarları, yön kuralı, montaj sırası, halat yolu, test listesi
    [cap3.stl, collar0.stl, collar1.stl, collar2.stl, drum.stl, mini_direk.scad, pulley.stl, stand.stl]
2026-10-04 mekanik: 3 m teleskopik direğin basılacak parçaları (alüminyum borular için)
    - Yakalar (değiştirilebilir pabuçlu parmaklar, rulmanlı makara kulakları, halat bağlama,
    kamera plakası), kapak, ayak kılıfları, iç tıpalar, 3 kalınlıkta kayar pabuç,
    623ZZ rulmanlı makara, taban yuvası, motor tamburu
    - Pabuçlar kayan yüzü üstte basılır (ütüleme); kayan yüzeylerde vida başı yok
    - Parçalar delme şablonu; iç borular dıştakine alttan girer
    - Çakışma testi 0/300/600/750 mm: temiz; normal sınır x=600 (230 mm örtüşme)
    - README: baskı, hırdavat, yön kuralı, delme, montaj, kayma ayarı
    [base.stl, cap3.stl, collar0.stl, collar1.stl, collar2.stl, direk_3m.scad, drum.stl, pad_2.5.stl]
2026-10-04 mekanik: 3 m direk için A1'e dizilmiş üç baskı tablası (.3mf)
    [tabla1_pabuclar.3mf, tabla2_yakalar_makaralar.3mf, tabla3_taban_tipalar.3mf]
2026-10-04 mekanik: makara oluğu düzeltildi (kendini kesen profil), rulman yuvası üstten açık
    [collar0.stl, collar1.stl, collar2.stl, direk_3m.scad, pulley.stl, tabla1_pabuclar.3mf, tabla2_yakalar_makaralar.3mf, tabla3_taban_tipalar.3mf]
2026-10-07 docs: alışveriş listesi; motor 5840-31ZY enkoderli, BTS7960 sürücü, 1,2 mm Dyneema ip
2026-10-07 jetson: L4T paketleri Arducam sürücüsü için sabitlenir; servis depogoz_fc kullanıcısına göre
2026-10-07 backend: numpy<2 (Jetson OpenCV numpy 1.x ile derlenmiş)
2026-10-07 kamera: Jetson CSI (CamArray + 4×IMX519) canlı görüntü, odak, otomatik odak, çek-ve-oku
    - services/camera.py: Argus akışı, HAT dörtlü mod, AK7375 odak motoru, kontrast ile otomatik odak,
    kullanılmayınca kamerayı bırakma
    - services/camera_read.py: dört görüntüde kod çözme, gözü stok listesinden bulma, elle taramaya işleme
    - api/camera.py: /api/camera, /stream (MJPEG), /snapshot, /focus, /autofocus, /read
2026-10-07 arayüz: ekran kartı yoksa 3B sahne düşük çözünürlükte çizilir (Jetson snap Chromium)
2026-10-29 Dayanıklı QR okuma, test sayfası ve benchmark; ekip için çalışma rehberi
    - decoder: hasarlı/bozuk etiketler için ek okuma yolu; /api/decode robust seçeneği
    - test_sheet: yazdırılabilir A4 barkod/QR test sayfası (depogoz print-sheet, /api/test-sheet)
    - qr_benchmark/qr_degrade: hasar dayanıklılık testi (depogoz benchmark)
    - kamera: tek kanal seçeneği (camera_channel)
    - docs/CALISMA_REHBERI.md: ağ/IP, SSH, iş akışı, kameralar, bilinen tuzaklar
    - .gitignore: dilimleyici çıktıları
2026-10-29 jetson: güç butonuna kısa basınca kapatan servis
    GNOME (gsd-media-keys) güç tuşu için logind'e engelleme kilidi koyduğu için
    logind.conf'taki HandlePowerKey işlemiyordu. guc_tusu.py tuşu gpio-keys
    aygıtından doğrudan okur ve systemctl poweroff çağırır.
